pepaslabs/PCFanMagneticStirrer/Construction/stirrer1.jpg

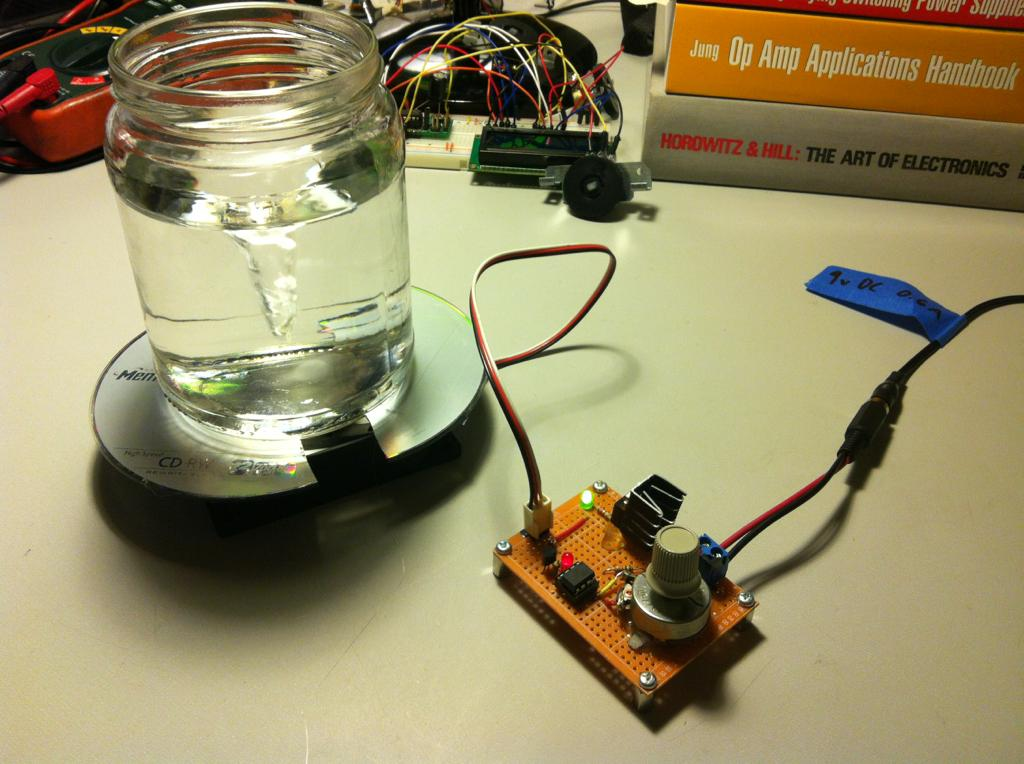
Construction/stirrer1.jpg
