pepaslabs/PCFanMagneticStirrer/Construction/stirrer3.jpg

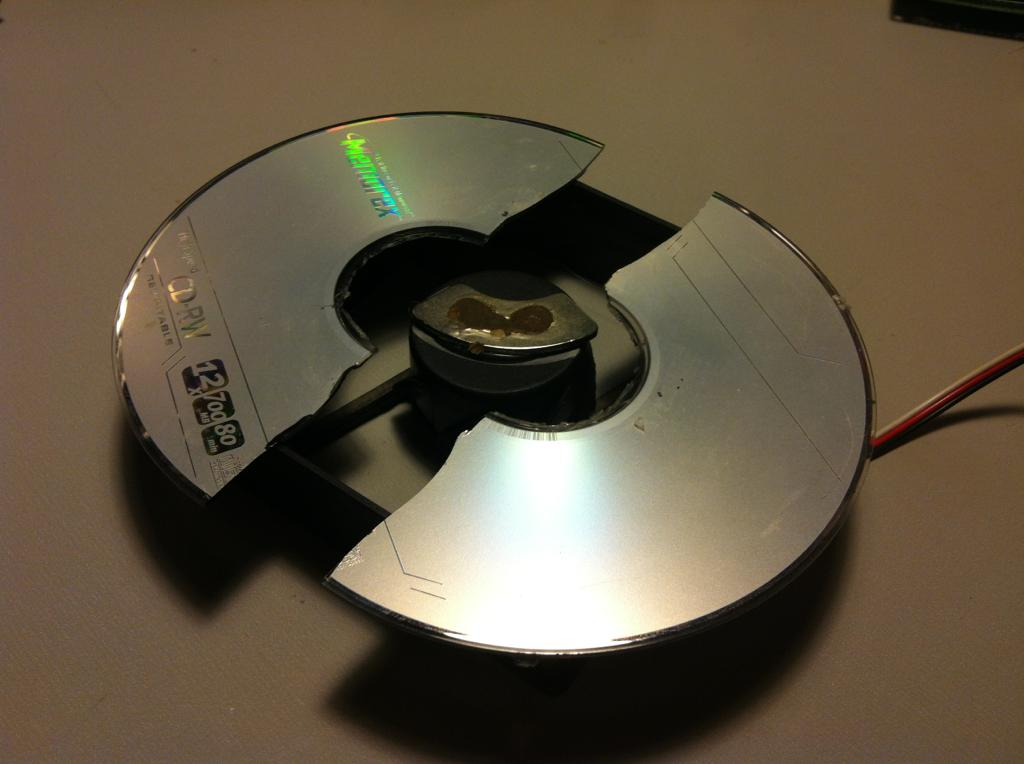
Construction/stirrer3.jpg
