pepaslabs/PCFanMagneticStirrer/Eagle/power_supply.png

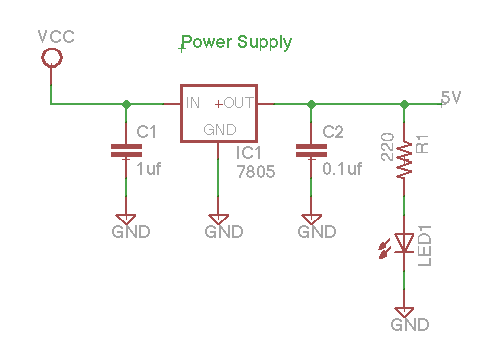
Eagle/power_supply.png
