pepaslabs/PCFanMagneticStirrer/Eagle/stirrer.png

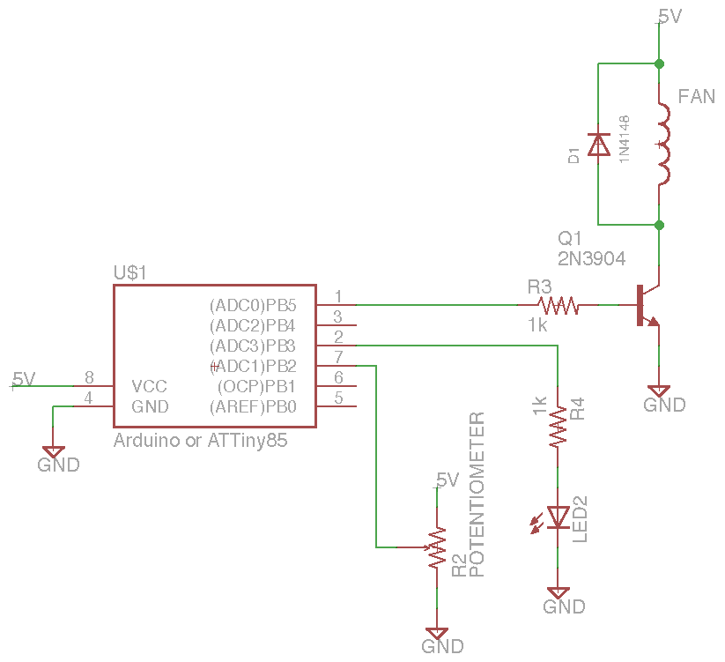
Eagle/stirrer.png
