pepaslabs/PCFanMagneticStirrer/Eagle/stirrer.sch

## EAGLE design Eagle/stirrer.sch (2013-09-20)

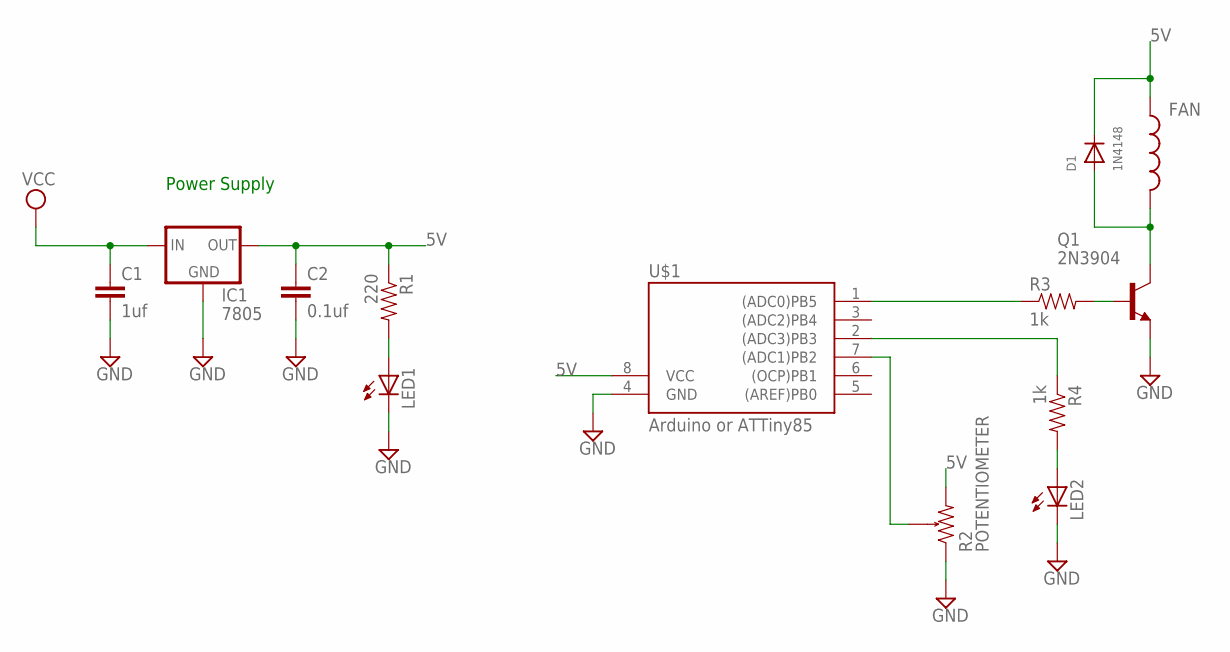
[picture p5: schematic stirrer.sch]

Parts:
C1: 1uf; CAP-PTH-SMALL
C2: 0.1uf; CAP-PTH-SMALL
D1: 1N4148; DO-1N4148
FAN: INDUCTOR-; CDRH3D28
IC1: 7805; TO-220-ALT
LED1, LED2: LED5MM
Q1: 2N3904; TO92
R1: 220; AXIAL-0.4
R2: POTENTIOMETER; 0603-ARV
R3, R4: 1k; AXIAL-0.4
U$1: Arduino or ATTiny85; SOIC8

Connections:
5V: C2.1, D1.C, FAN.1, IC1.OUT, R1.P$1 (1), R2.2, U$1.8 (VCC)
GND: C1.2, C2.2, IC1.GND, LED1.K (C), LED2.K (C), Q1.3 (E), R2.1, U$1.4 (GND)
unnamed: LED1.A, R1.P$2 (2)
unnamed: D1.A, FAN.2, Q1.1 (C)
unnamed: R2.3, U$1.7 ((ADC1)PB2)
unnamed: LED2.A, R4.P$2 (2)
unnamed: Q1.2 (B), R3.P$2 (2)
unnamed: R3.P$1 (1), U$1.1 ((ADC0)PB5)
unnamed: R4.P$1 (1), U$1.2 ((ADC3)PB3)
VCC: C1.1, IC1.IN

Notes on the sheet:
Power Supply
