pepaslabs/PCFanMagneticStirrer/Construction/stirrer2.jpg

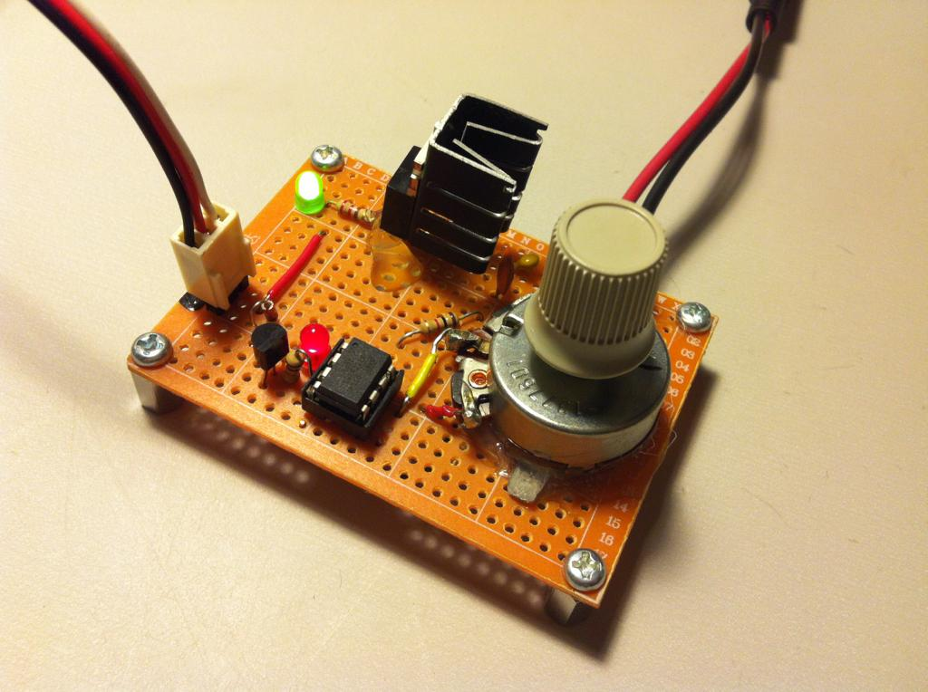
Construction/stirrer2.jpg
