pepaslabs/PCFanMagneticStirrer/Construction/stirrer4.jpg

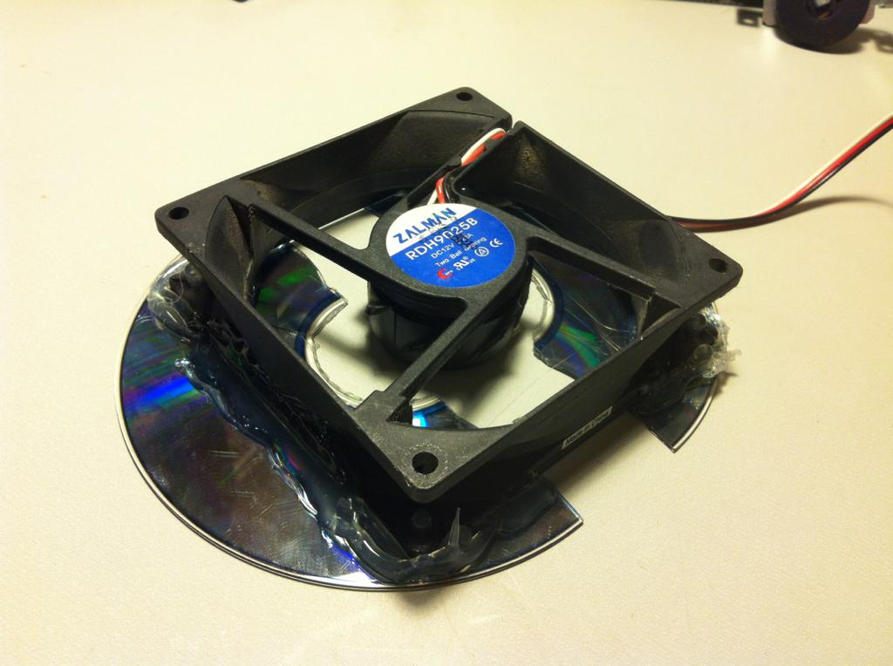
Construction/stirrer4.jpg
