pepaslabs/PCFanMagneticStirrer/(commit log)

2013-09-20 Adding Eagle schematic file and screenshots.
    [stirrer.sch]
2013-09-20 Changing R4 from 220 to 1k.
    [stirrer.sch]
